riley-strode/ENCE_3231_Riley_Strode_2026/Two_Wheel_Balancing_Robot_v2/Two_Wheel_Balancing_Robot_v2/docs/PCB_Layout.png

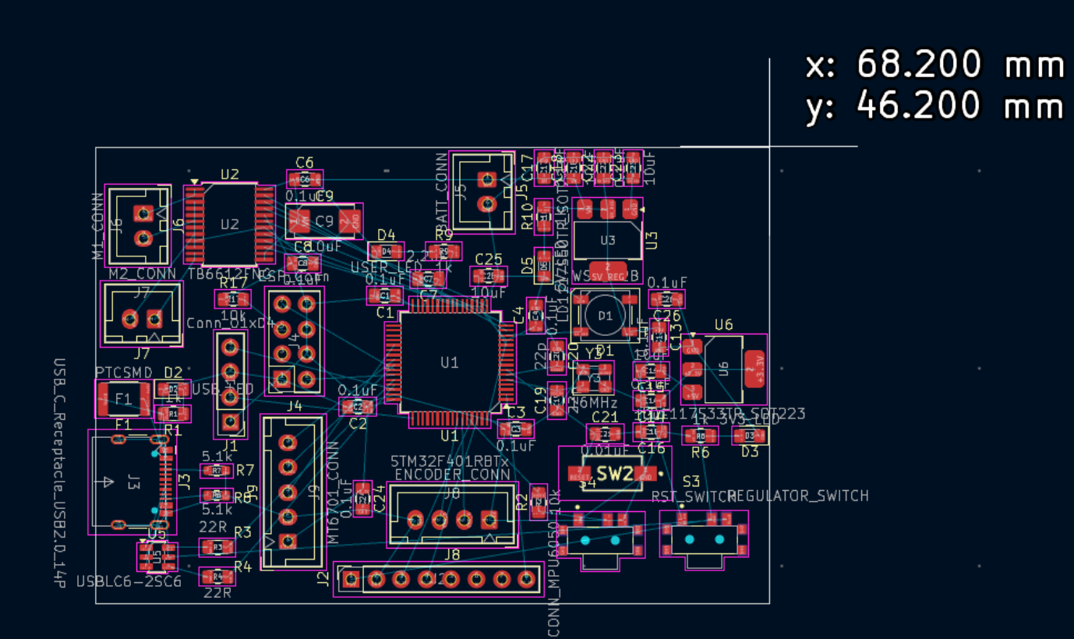
Two_Wheel_Balancing_Robot_v2/Two_Wheel_Balancing_Robot_v2/docs/PCB_Layout.png
