riley-strode/ENCE_3231_Riley_Strode_2026/Phase_D/Riley_Chassis_v4.DXF

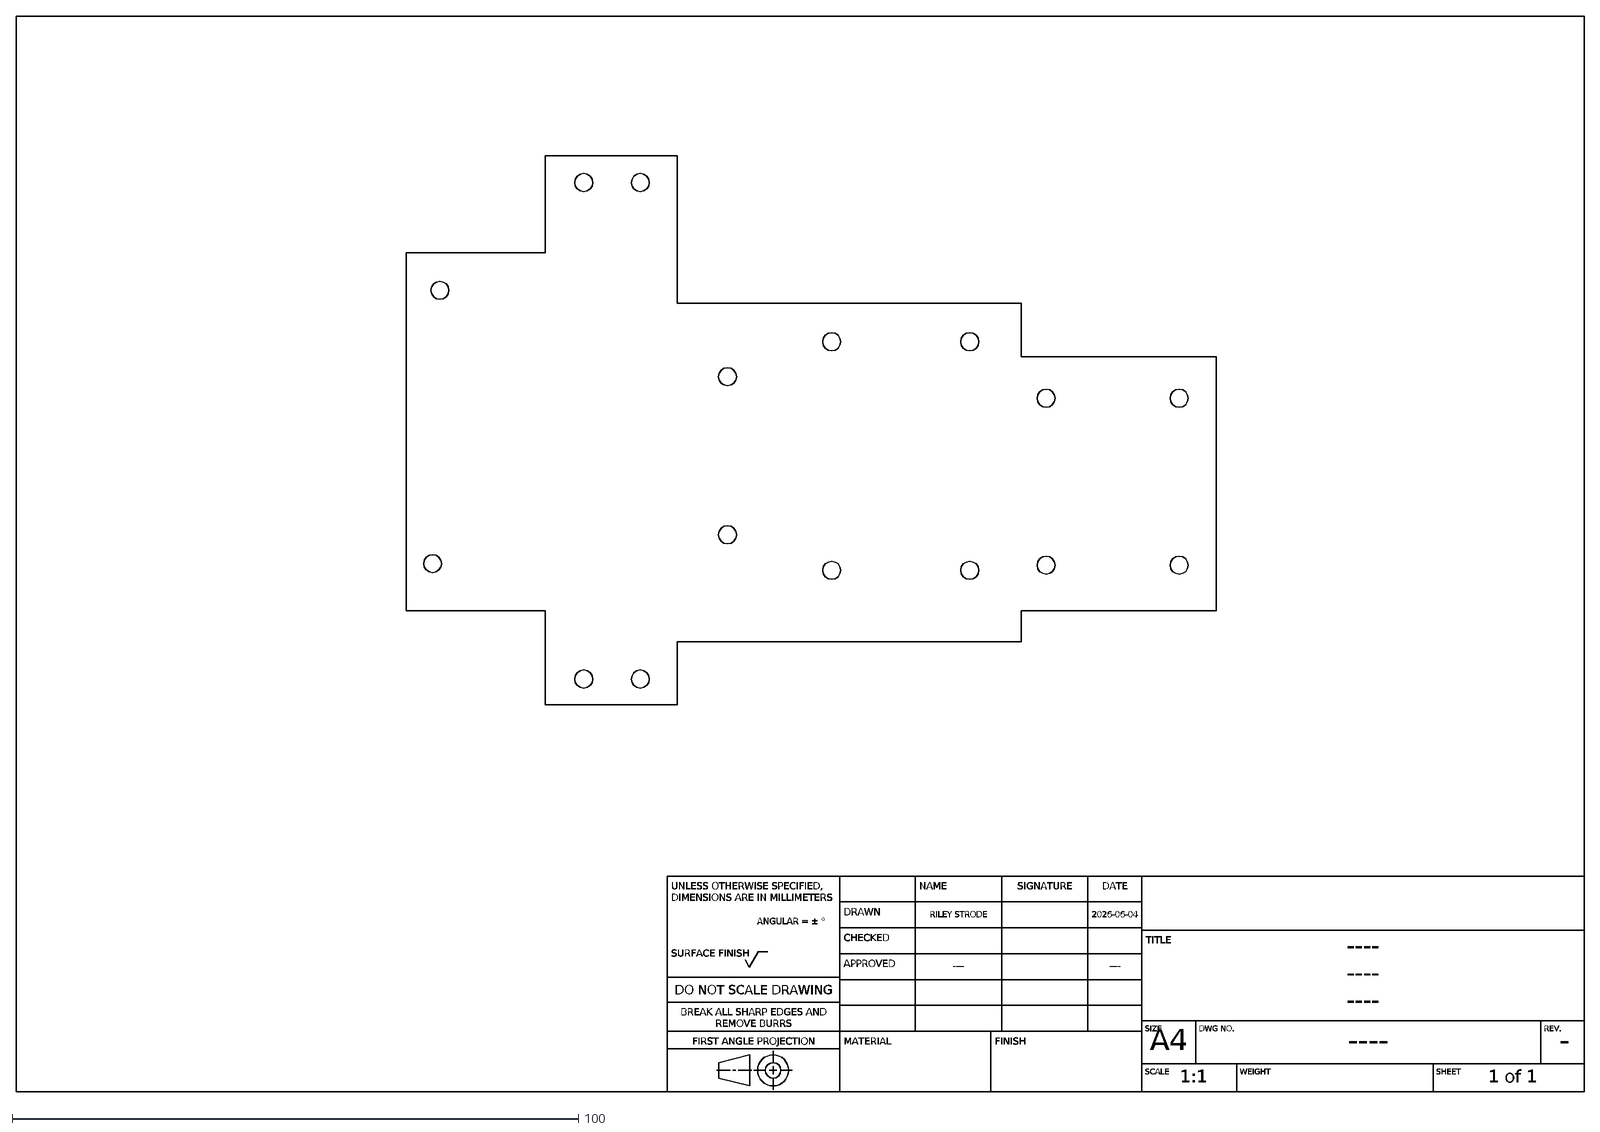
[picture p11: CAD file, 2026-06-09]
Phase_D/Riley_Chassis_v4.DXF
UNLESS OTHERWISE SPECIFIED, DIMENSIONS ARE IN MILLIMETERS
ANGULAR = ± °
SURFACE FINISH
DO NOT SCALE DRAWING
BREAK ALL SHARP EDGES AND REMOVE BURRS
FIRST ANGLE PROJECTION
SIGNATURE
NAME
DATE
DRAWN
RILEY STRODE
2026-06-04
CHECKED
APPROVED
----
MATERIAL
FINISH
TITLE
SIZE
A4
DWG NO.
REV.
-
SCALE
1:1
WEIGHT
SHEET
1 of 1
