riley-strode/ENCE_3231_Riley_Strode_2026/Phase_D/Two_Wheel_Balancing_Robot_v3_KiCad/components/ESP8266-01_ESP-01/step/ESP8266-01_ESP-01.step

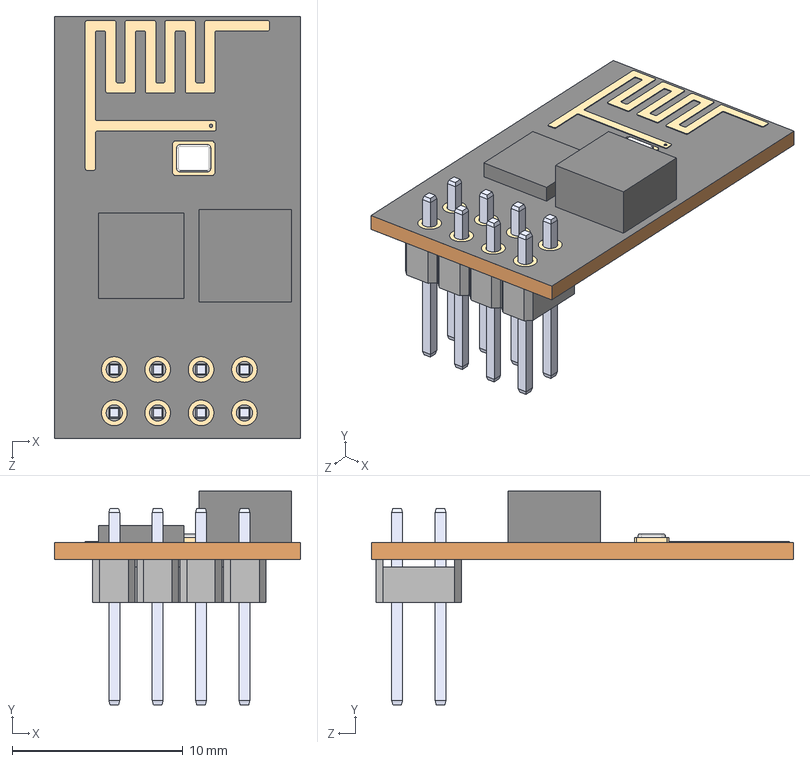
[picture p13: CAD file, 2026-04-23]
Phase_D/Two_Wheel_Balancing_Robot_v3_KiCad/components/ESP8266-01_ESP-01/step/ESP8266-01_ESP-01.step
14.4 x 12.5 x 24.7 mm
