riley-strode/ENCE_3231_Riley_Strode_2026/Phase_D/Two_Wheel_Balancing_Robot_v3_KiCad/components/Fuse_3DModel/MF-MSMF050-2--3DModel-STEP-56544.STEP

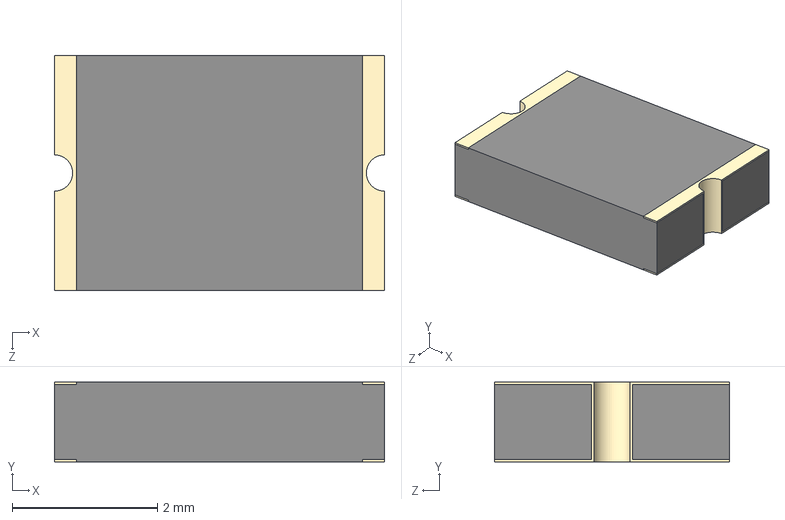
[picture p14: CAD file, 2026-04-23]
Phase_D/Two_Wheel_Balancing_Robot_v3_KiCad/components/Fuse_3DModel/MF-MSMF050-2--3DModel-STEP-56544.STEP
4.55 x 1.10 x 3.24 mm
