riley-strode/ENCE_3231_Riley_Strode_2026/Phase_D/Two_Wheel_Balancing_Robot_v3_KiCad/components/MPU6050/ITG-MPU.STEP

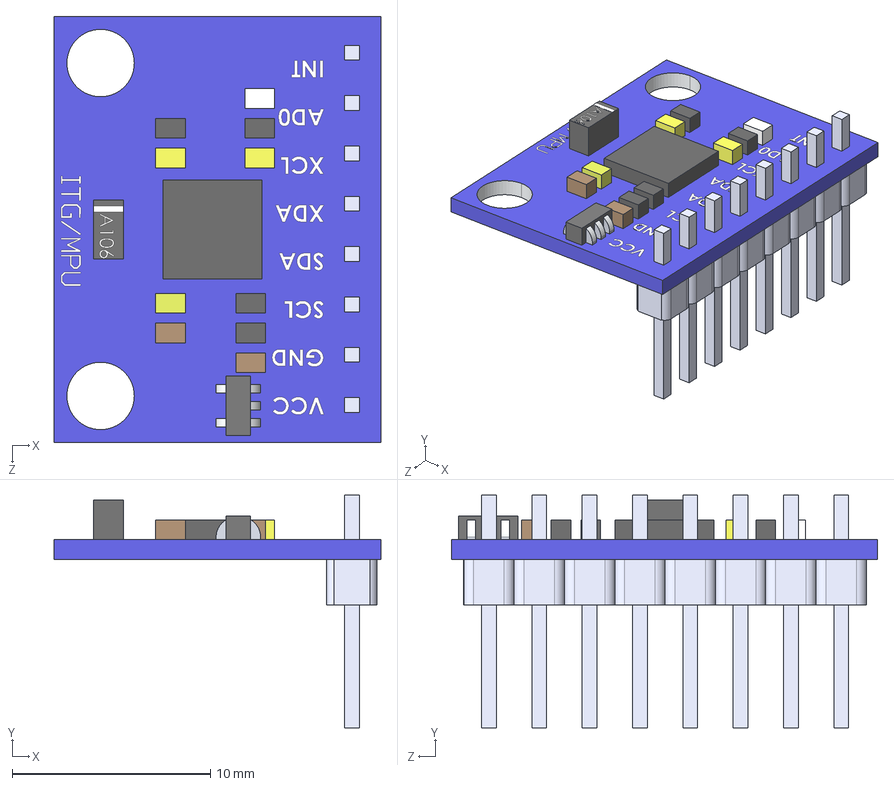
[picture p15: CAD file, 2026-04-23]
Phase_D/Two_Wheel_Balancing_Robot_v3_KiCad/components/MPU6050/ITG-MPU.STEP
16.5 x 11.8 x 21.5 mm
8 Header-Pin
Placa_Base
