riley-strode/ENCE_3231_Riley_Strode_2026/Phase_D/Two_Wheel_Balancing_Robot_v3_KiCad/components/SPDT_Slide_Switch/step/SLW-66527511-SMT-TR.step

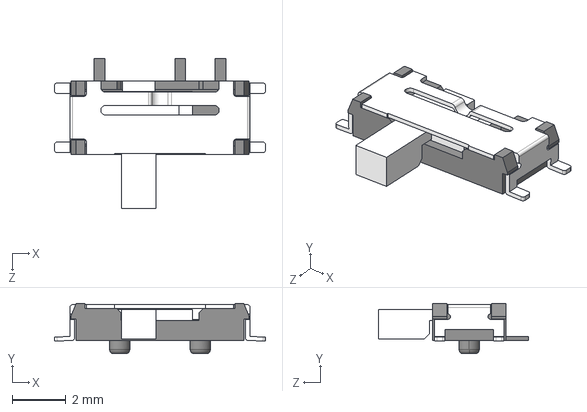
[picture p16: CAD file, 2026-04-23]
Phase_D/Two_Wheel_Balancing_Robot_v3_KiCad/components/SPDT_Slide_Switch/step/SLW-66527511-SMT-TR.step
7.86 x 1.88 x 5.58 mm
