riley-strode/ENCE_3231_Riley_Strode_2026/Phase_D/Two_Wheel_Balancing_Robot_v3_KiCad/components/SW_uP_Reset/step/SW_uP_Reset.stp

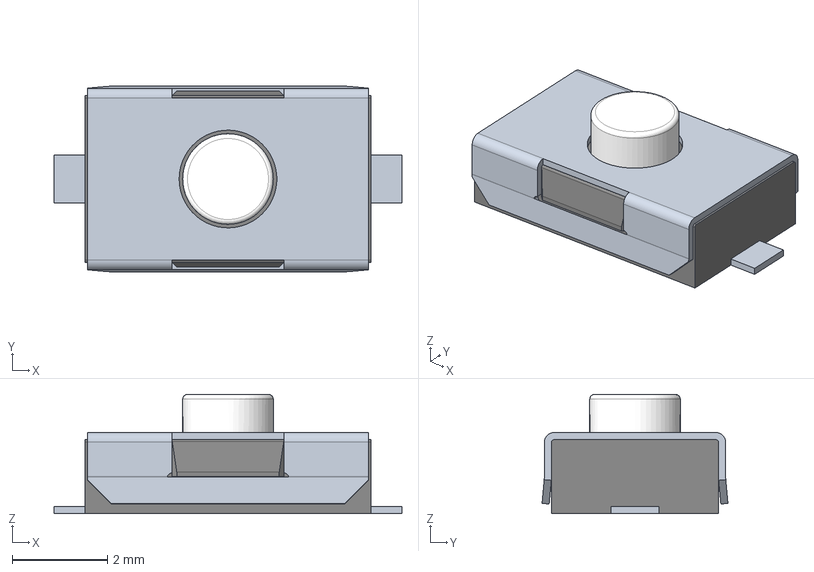
[picture p17: CAD file, 2026-04-23]
Phase_D/Two_Wheel_Balancing_Robot_v3_KiCad/components/SW_uP_Reset/step/SW_uP_Reset.stp
7.30 x 3.90 x 2.50 mm

Phil's_Lab_Tutorial_Folder/Phil's_Lab_Tutorial/Components/629105150521 (rev1).stp
8.00 x 6.60 x 4.52 mm
629105150521_Housing
629105150521_Pin1 x 4
629105150521_Pin2
629105150521_Shielding2
629105150521_Shielding
