riley-strode/ENCE_3231_Riley_Strode_2026/(list of files, cad)

Other CAD files:
Phase_D/Two_Wheel_Balancing_Robot_v3_KiCad/docs/CAD_BASE_WHEEL_BALANCE.step
