riley-strode/ENCE_3231_Riley_Strode_2026/Lab_1_Ultrasonic_Sensor/Embedded Systems Lab 1 Block Diagram 1.pdf

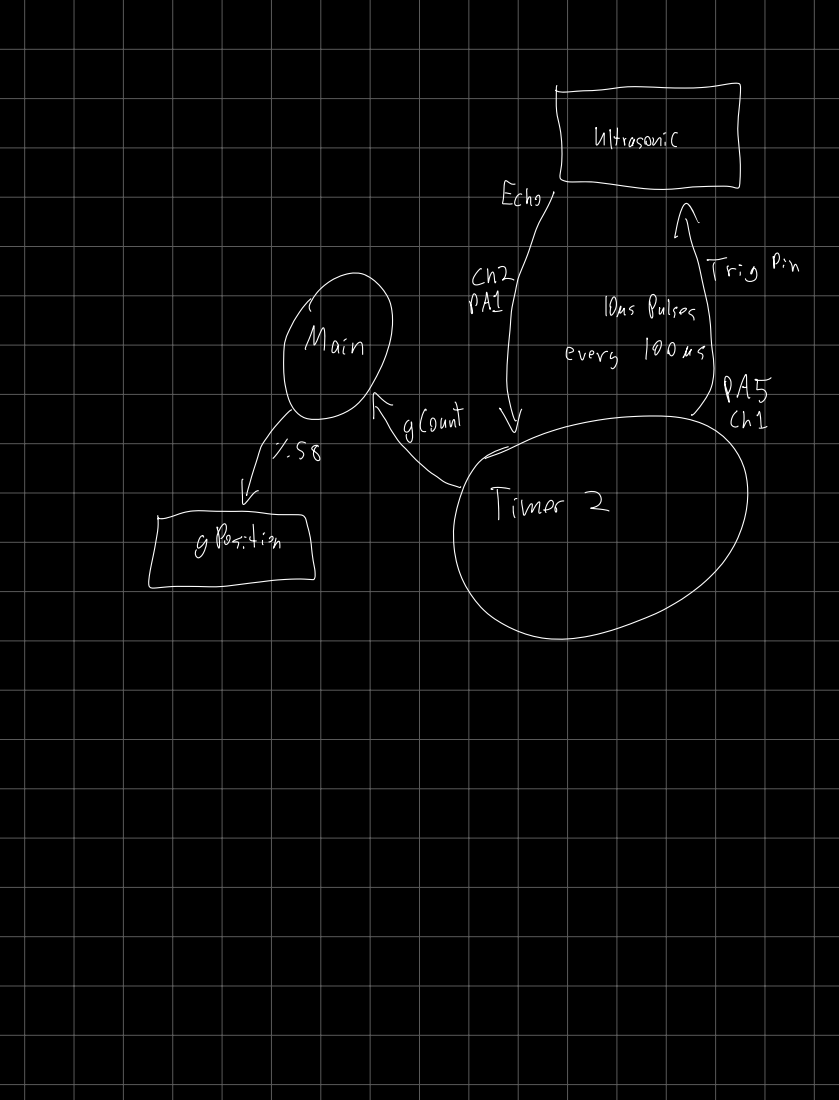
[picture p19: page 1]
UltrasonicEchoTrig; PinCh2; PAI10ms; Pulses; every 100msMainPAS Ch1glount1 58Timer; Position
