riley-strode/ENCE_3231_Riley_Strode_2026/Phase_D/Riley_Chassis_v4.pdf

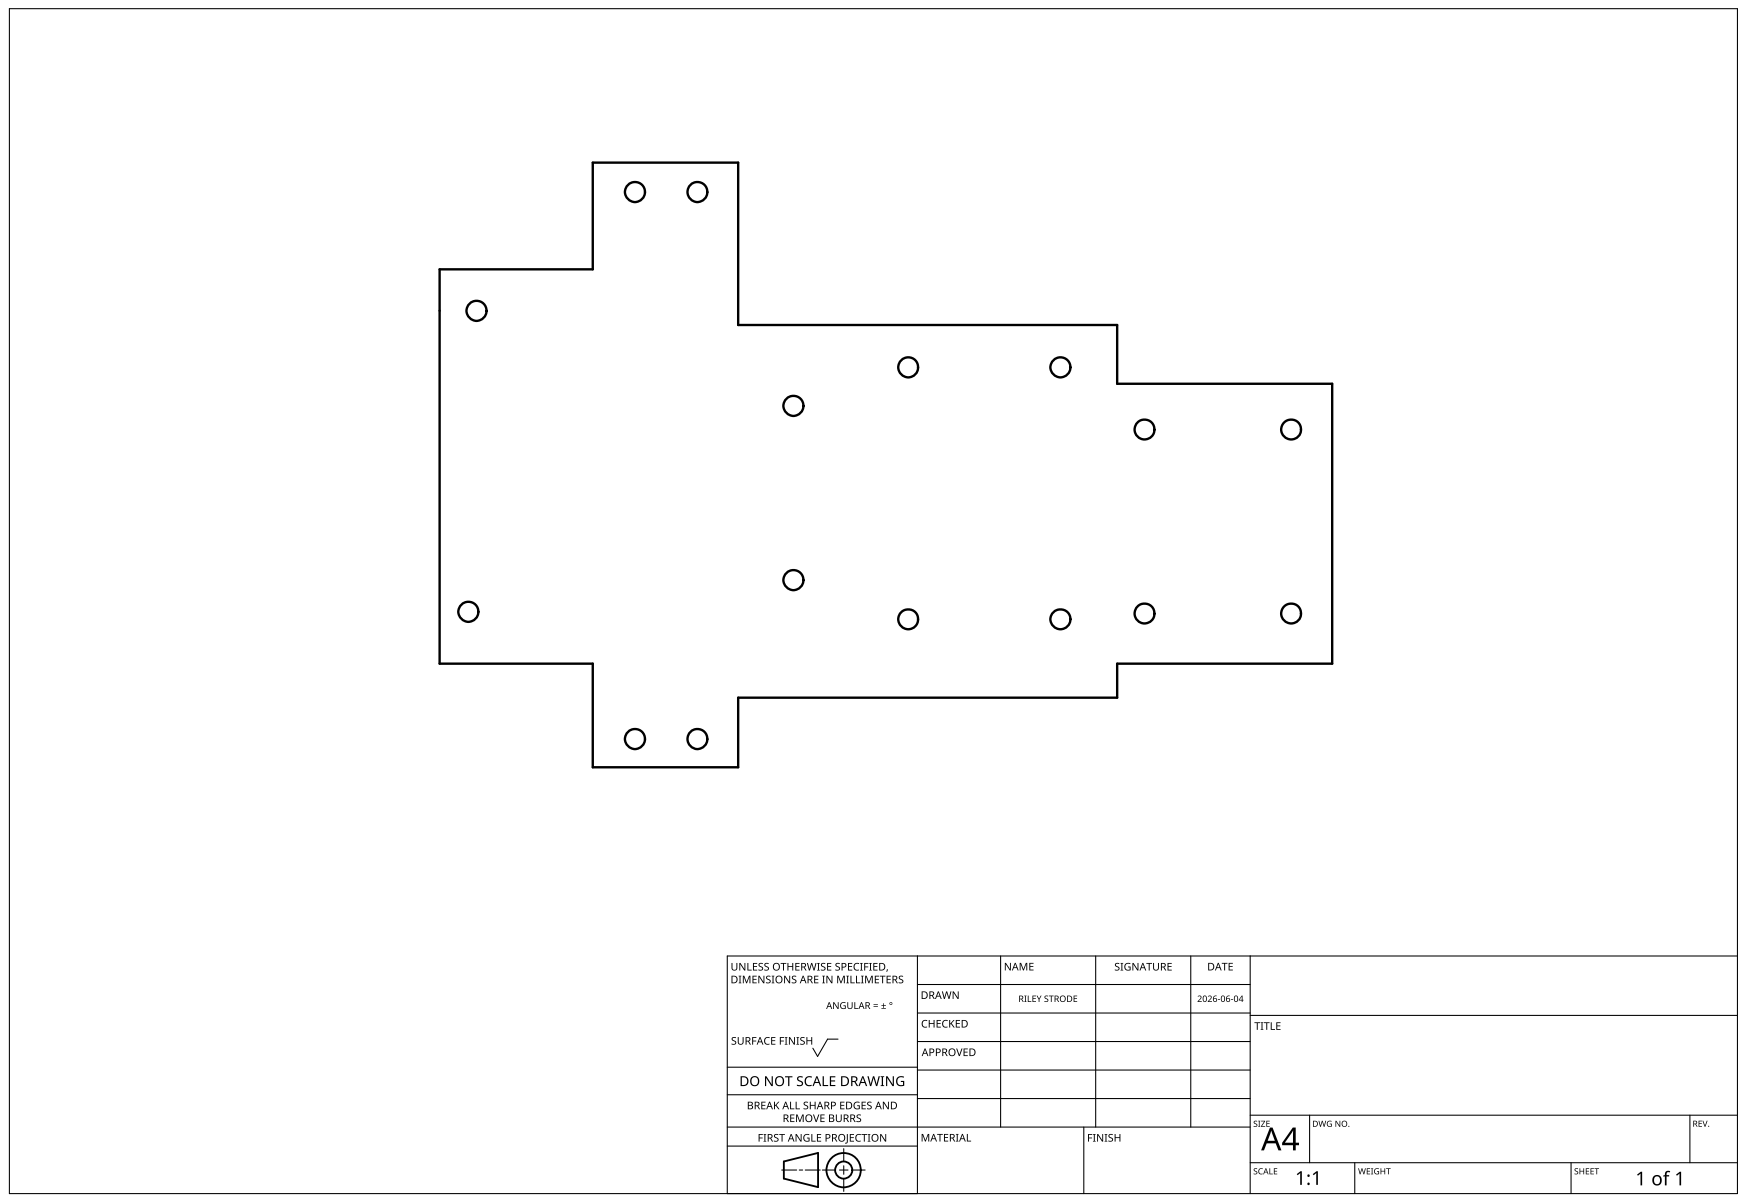
[picture p20: page 1]
