riley-strode/ENCE_3231_Riley_Strode_2026/Phase_D/Two_Wheel_Balancing_Robot_v3_KiCad/docs/Riley_Strode_Chassis.pdf

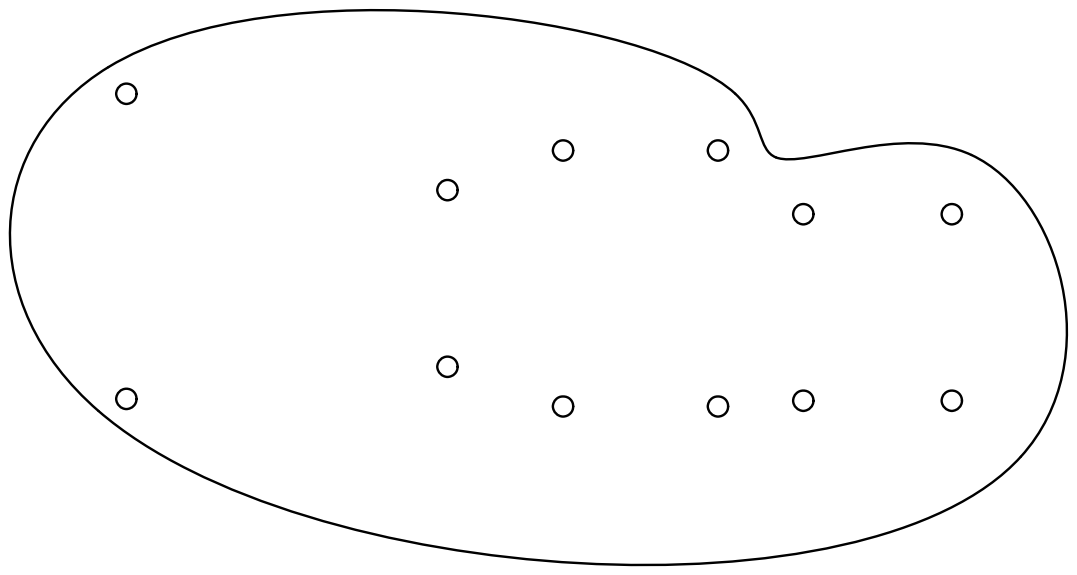
[picture p21: page 1]
