riley-strode/ENCE_3231_Riley_Strode_2026/Phase_D/Two_Wheel_Balancing_Robot_v3_KiCad/docs/Riley_Strode_Chassis_v2.pdf

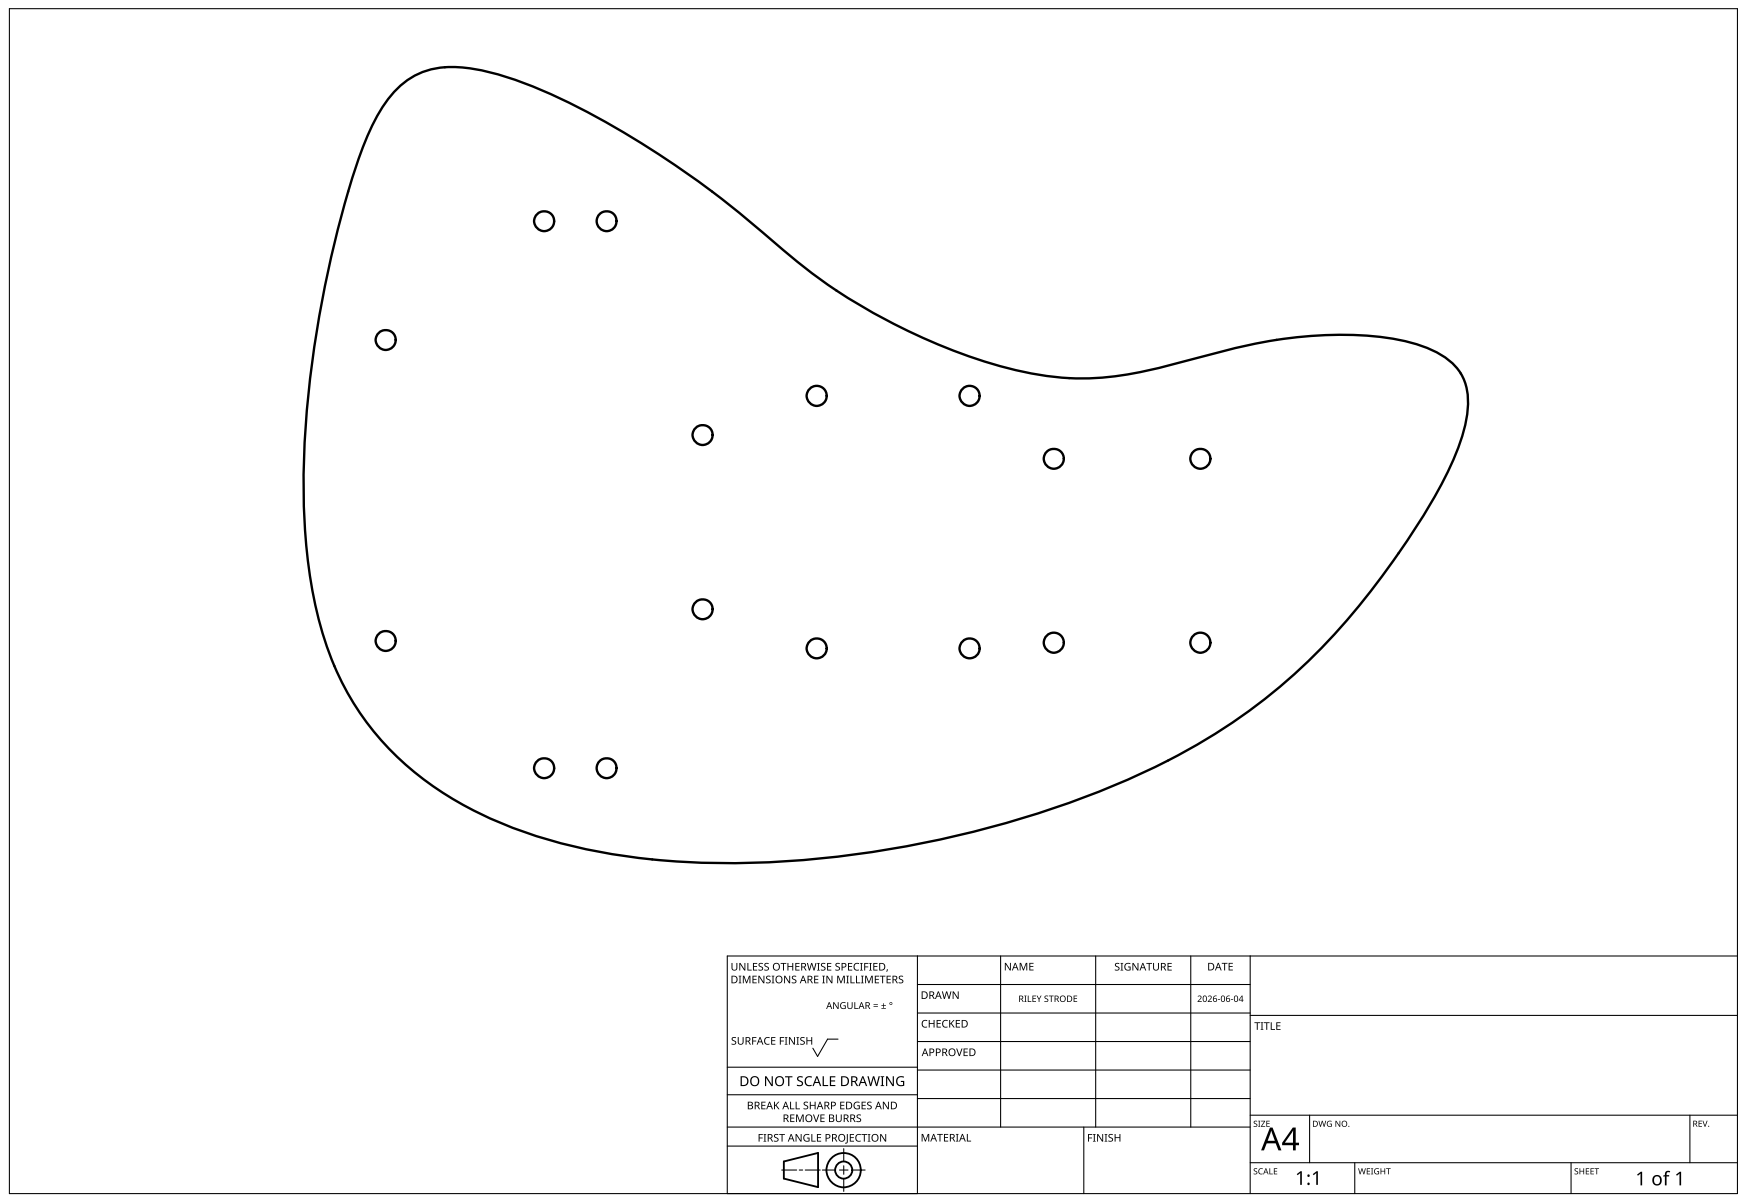
[picture p22: page 1]
