riley-strode/ENCE_3231_Riley_Strode_2026/Phil's_Lab_Tutorial_Folder/Phil's_Lab_Tutorial/Phil's_Lab_Tutorial.kicad_pcb

## KiCad design Phil's_Lab_Tutorial_Folder/Phil's_Lab_Tutorial/Phil's_Lab_Tutorial.kicad_pcb (2026-04-28)

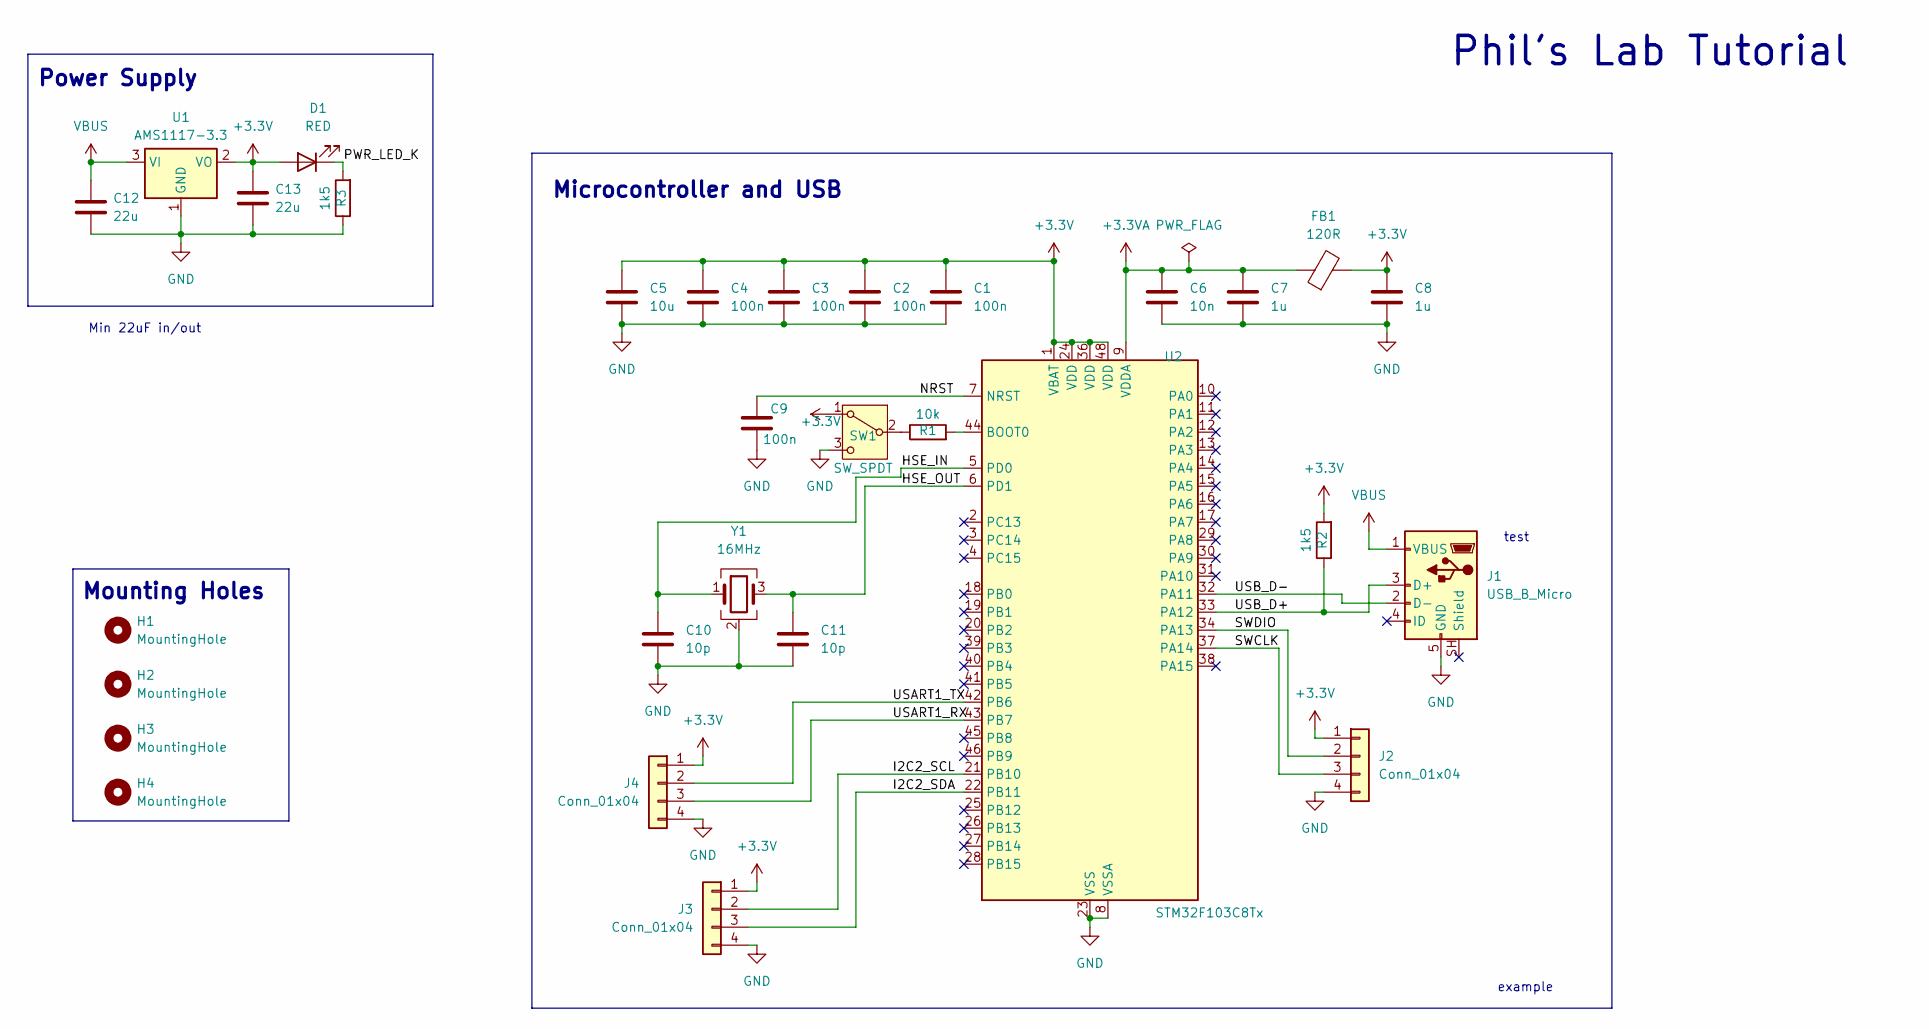
[picture p25: schematic Phil's_Lab_Tutorial.kicad_sch, Phil's Lab Tutorial]

Parts:
C1, C2, C3, C4, C9: 100n; C_0402_1005Metric
C5: 10u; C_0603_1608Metric
C6: 10n; C_0603_1608Metric
C7, C8: 1u; C_0402_1005Metric
C10, C11: 10p; C_0402_1005Metric
C12, C13: 22u; C_0805_2012Metric
D1: RED; LED_0603_1608Metric
FB1: 120R; L_0603_1608Metric
H1, H2, H3, H4: MountingHole; MountingHole_2.2mm_M2
J1: USB_B_Micro; USB_Micro-B_Technik_TWP-4002D-H3
J2, J3, J4: Conn_01x04; PinHeader_1x04_P2.54mm_Vertical
R1: 10k; R_0402_1005Metric
R2, R3: 1k5; R_0402_1005Metric
SW1: SW_SPDT; SuperSOT-3
U1: AMS1117-3.3; SOT-223-3_TabPin2
U2: STM32F103C8Tx; LQFP-48_7x7mm_P0.5mm
Y1: 16MHz; Crystal_SMD_3225-4Pin_3.2x2.5mm

Connections:
+3.3V: C1.1, C2.1, C3.1, C4.1, C5.1, C8.1, C13.1, D1.2 (A), FB1.2, J2.1, J3.1, J4.1, R2.2, SW1.1 (A), U1.2 (VO), U2.1 (VBAT), U2.24 (VDD), U2.36 (VDD), U2.48 (VDD)
+3.3VA: C6.1, C7.1, FB1.1, U2.9 (VDDA)
/HSE_IN: C10.1, U2.5 (PD0), Y1.1
/HSE_OUT: C11.1, U2.6 (PD1), Y1.3
/I2C2_SCL: J3.2, U2.21 (PB10)
/I2C2_SDA: J3.3, U2.22 (PB11)
/NRST: C9.1, U2.7 (NRST)
/PWR_LED_K: D1.1 (K), R3.2
/SWCLK: J2.3, U2.37 (PA14)
/SWDIO: J2.2, U2.34 (PA13)
/USART1_RX: J4.3, U2.43 (PB7)
/USART1_TX: J4.2, U2.42 (PB6)
/USB_D+: J1.3 (D+), R2.1, U2.33 (PA12)
/USB_D-: J1.2 (D-), U2.32 (PA11)
GND: C1.2, C2.2, C3.2, C4.2, C5.2, C6.2, C7.2, C8.2, C9.2, C10.2, C11.2, C12.2, C13.2, J1.5 (GND), J2.4, J3.4, J4.4, R3.1, SW1.3 (C), U1.1 (GND), U2.8 (VSSA), U2.23 (VSS), U2.35 (VSS), U2.47 (VSS), Y1.2 (G), Y1.4 (G)
unnamed: R1.1, SW1.2 (B)
unnamed: R1.2, U2.44 (BOOT0)
VBUS: C12.1, J1.1 (VBUS), U1.3 (VI)

Notes on the sheet:
Microcontroller and USB
Mounting Holes
example
Phil's Lab Tutorial
Min 22uF in/out
Power Supply
test

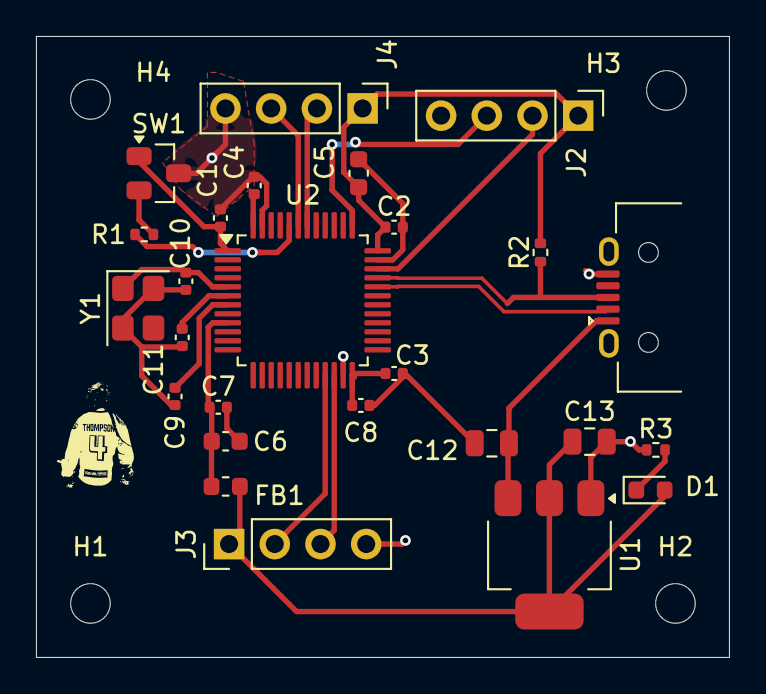
[picture p26: board Phil's_Lab_Tutorial.kicad_pcb from above]

Board: 2 copper layers, 38.5 x 34.5 mm, 30 parts (0 on the bottom side), 18 nets.
