riley-strode/ENCE_3231_Riley_Strode_2026/Two_Wheel_Balancing_Robot_v1/Two_Wheel_Balancing_Robot_v1.kicad_pcb

## KiCad design Two_Wheel_Balancing_Robot_v1/Two_Wheel_Balancing_Robot_v1.kicad_pcb (2026-04-23, an earlier design)

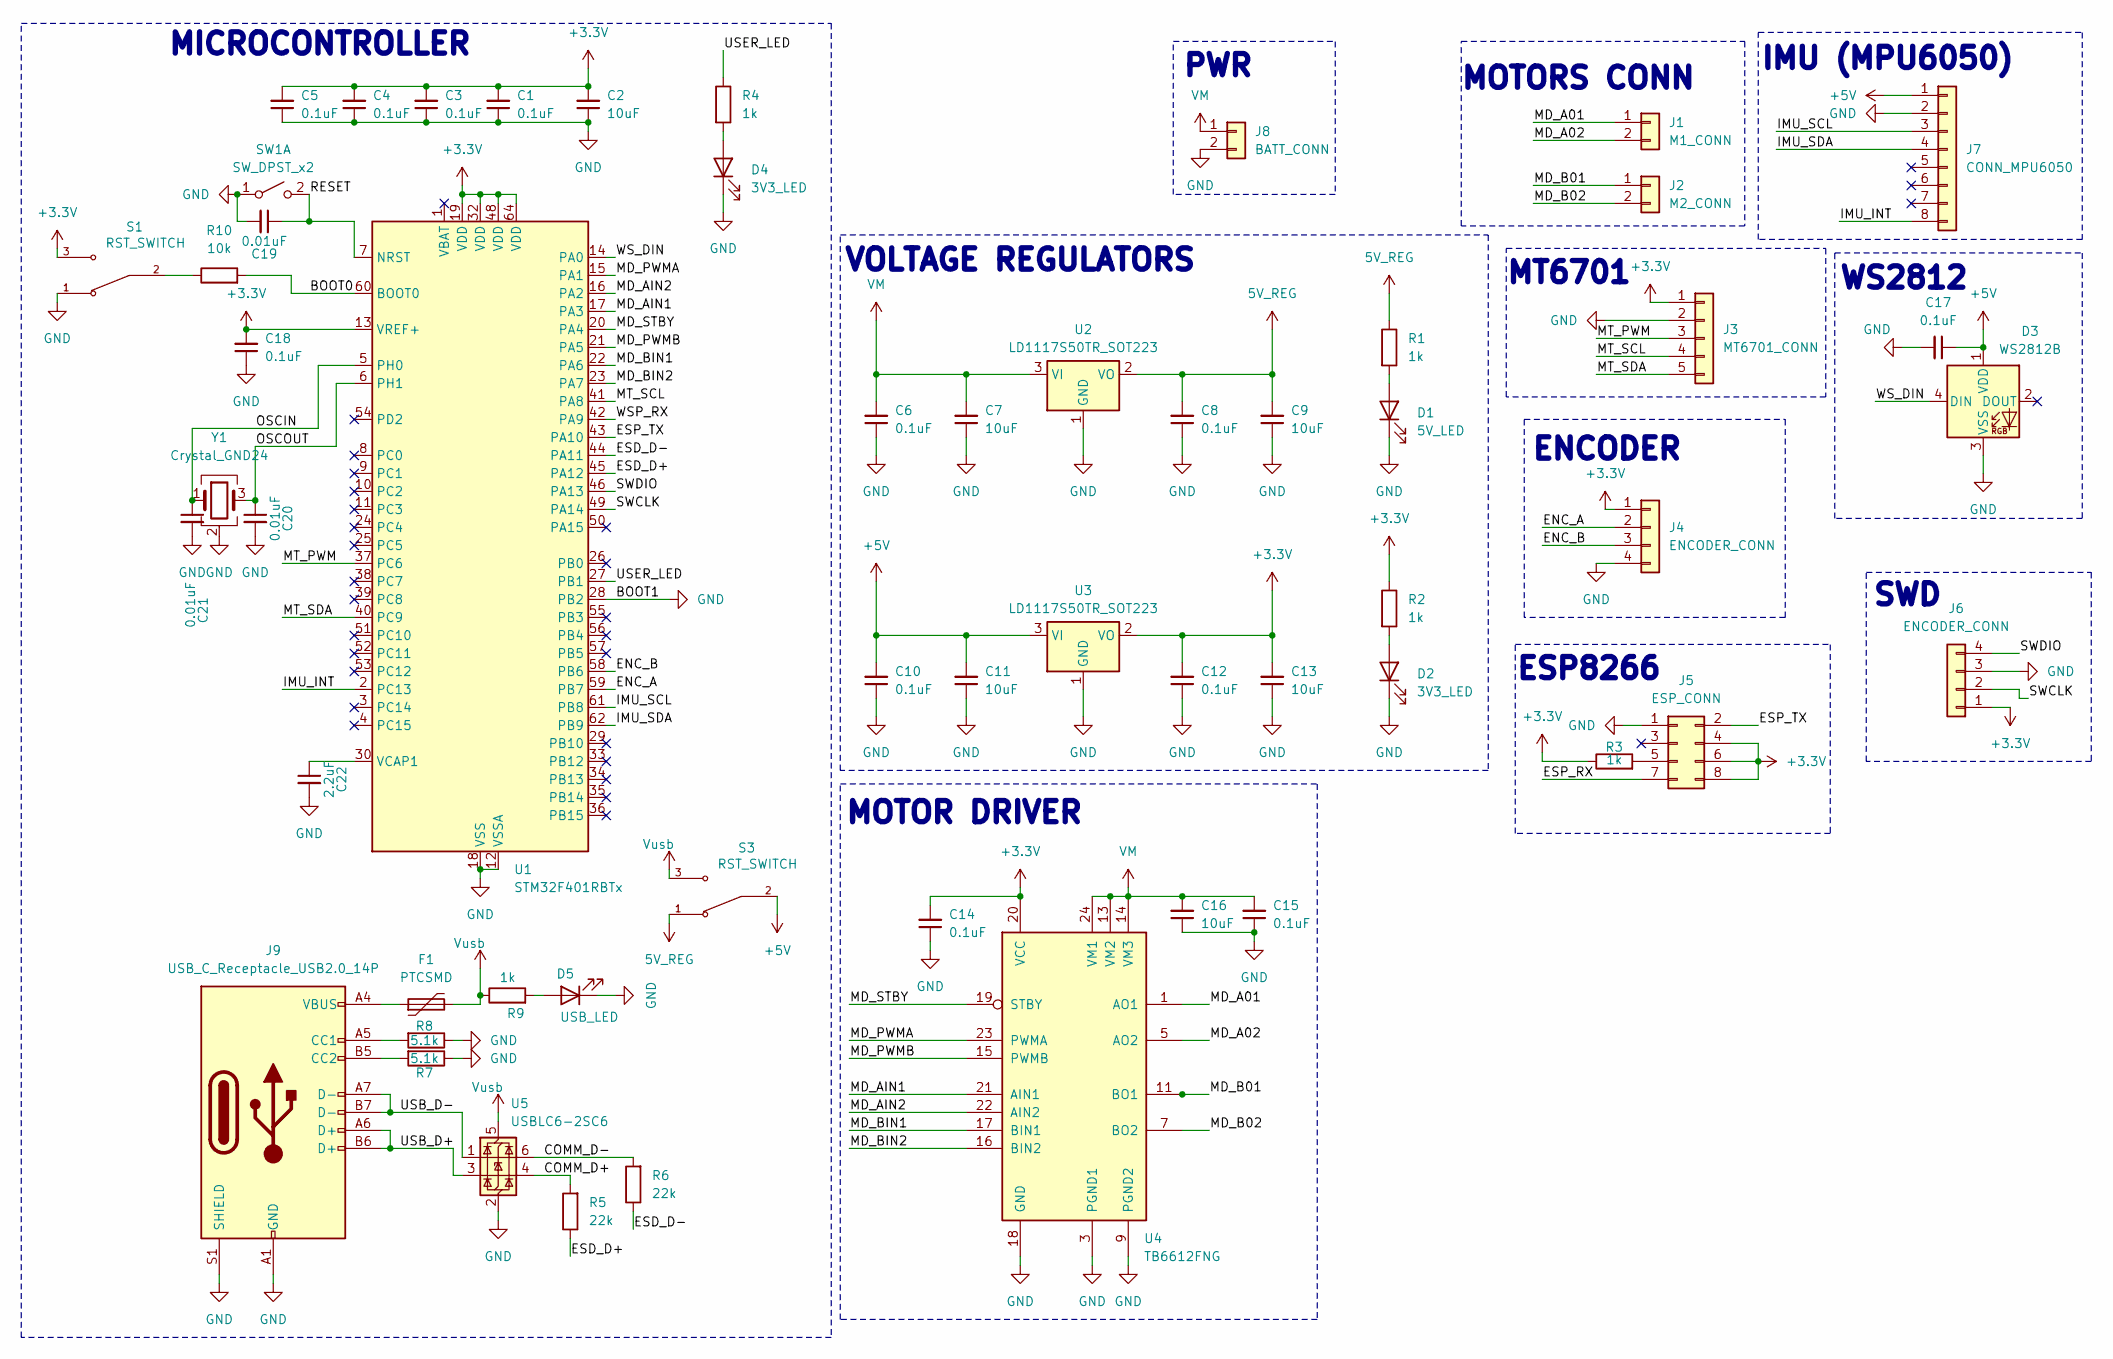
[picture p27: schematic Two_Wheel_Balancing_Robot_v1.kicad_sch]

Parts:
C1, C3, C4, C5, C6, C8, C10, C12, C14, C15, C17, C18: 0.1uF; C_0805_2012Metric_Pad1.18x1.45mm_HandSolder; Mfr. # KAM21BR71H104JM
C2, C7, C9, C11, C13, C16: 10uF; C_0805_2012Metric_Pad1.18x1.45mm_HandSolder; Mfr. # CGA4J1X7R0J106K125AC
C19, C20, C21: 0.01uF; C_0805_2012Metric_Pad1.18x1.45mm_HandSolder; Mfr. # KAM21BR71H104JM
C22: 2.2uF; C_0805_2012Metric_Pad1.18x1.45mm_HandSolder; Mfr. # KAM21BR71H104JM
D1: 5V_LED; LED_0805_2012Metric_Pad1.15x1.40mm_HandSolder; Mfr. # LY M676-R2T1-26-Z
D2, D4: 3V3_LED; LED_0805_2012Metric_Pad1.15x1.40mm_HandSolder; Mfr. # LY M676-R2T1-26-Z
D3: WS2812B; LED_WS2812B_PLCC4_5.0x5.0mm_P3.2mm
D5: USB_LED; LED_0805_2012Metric_Pad1.15x1.40mm_HandSolder; Mfr. # LY M676-R2T1-26-Z
F1: PTCSMD; Fuse_1812_4532Metric
J1: M1_CONN; JST_XH_B2B-XH-A_1x02_P2.50mm_Vertical
J2: M2_CONN; JST_XH_B2B-XH-A_1x02_P2.50mm_Vertical
J3: MT6701_CONN; JST_XH_B5B-XH-A_1x05_P2.50mm_Vertical
J4: ENCODER_CONN; JST_XH_B4B-XH-A_1x04_P2.50mm_Vertical
J5: ESP_CONN; PinSocket_2x04_P2.54mm_Vertical
J6: ENCODER_CONN; PinHeader_1x04_P2.54mm_Vertical
J7: CONN_MPU6050; PinSocket_1x08_P2.54mm_Vertical
J8: BATT_CONN; JST_XH_B2B-XH-A_1x02_P2.50mm_Vertical
J9: USB_C_Receptacle_USB2.0_14P; USB_C_Receptacle_HCTL_HC-TYPE-C-16P-01A
R1, R2, R3, R4, R9: 1k; R_0805_2012Metric_Pad1.20x1.40mm_HandSolder; Mfr. # WCR0805LF1001FPLT
R5, R6: 22k; R_0805_2012Metric_Pad1.20x1.40mm_HandSolder; Mfr. # WCR0805LF1001FPLT
R7, R8: 5.1k; R_0805_2012Metric_Pad1.20x1.40mm_HandSolder; Mfr. # WCR0805LF1001FPLT
R10: 10k; R_0805_2012Metric_Pad1.20x1.40mm_HandSolder; Mfr. # WCR0805LF1001FPLT
S1, S3: RST_SWITCH; SW_SLW-66527511-SMT-TR; PARTREV 1.01
SW1: SW_DPST_x2; SW_uP_Reset
U1: STM32F401RBTx; LQFP-64_10x10mm_P0.5mm; Mfr. # STM32F401RET6
U2, U3: LD1117S50TR_SOT223; SOT-223-3_TabPin2
U4: TB6612FNG; SSOP-24_5.3x8.2mm_P0.65mm
U5: USBLC6-2SC6; SOT-23-6
Y1: Crystal_GND24; Crystal_SMD_Abracon_ABM8G-4Pin_3.2x2.5mm

Connections:
5V_REG: C8.2, C9.2, R1.1, S3.1, U2.2 (VO)
+3.3V: C1.2, C2.2, C3.2, C4.2, C5.2, C12.2, C13.2, C14.2, C18.2, J3.1, J4.1, J5.4, J5.6, J5.8, J6.1, R2.1, R3.1, S1.3, U1.13 (VREF+), U1.19 (VDD), U1.32 (VDD), U1.48 (VDD), U1.64 (VDD), U3.2 (VO), U4.20 (VCC)
+5V: C10.2, C11.2, C17.1, D3.1 (VDD), J7.1, S3.2, U3.3 (VI)
/BOOT0: R10.2, U1.60 (BOOT0)
/COMM_D+: R5.2, U5.4 (I/O2)
/COMM_D-: R6.2, U5.6 (I/O1)
/ENC_A: J4.2, U1.59 (PB7)
/ENC_B: J4.3, U1.58 (PB6)
/ESD_D+: R5.1, U1.45 (PA12)
/ESD_D-: R6.1, U1.44 (PA11)
/ESP_RX: J5.7
/ESP_TX: J5.2, U1.43 (PA10)
/IMU_INT: J7.8, U1.2 (PC13)
/IMU_SCL: J7.3, U1.61 (PB8)
/IMU_SDA: J7.4, U1.62 (PB9)
/MD_A01: J1.1, U4.1 (AO1), U4.2 (AO1)
/MD_A02: J1.2, U4.5 (AO2), U4.6 (AO2)
/MD_AIN1: U1.17 (PA3), U4.21 (AIN1)
/MD_AIN2: U1.16 (PA2), U4.22 (AIN2)
/MD_B01: J2.1, U4.11 (BO1), U4.12 (BO1)
/MD_B02: J2.2, U4.7 (BO2), U4.8 (BO2)
/MD_BIN1: U1.22 (PA6), U4.17 (BIN1)
/MD_BIN2: U1.23 (PA7), U4.16 (BIN2)
/MD_PWMA: U1.15 (PA1), U4.23 (PWMA)
/MD_PWMB: U1.21 (PA5), U4.15 (PWMB)
/MD_STBY: U1.20 (PA4), U4.19 (STBY)
/MT_PWM: J3.3, U1.37 (PC6)
/MT_SCL: J3.4, U1.41 (PA8)
/MT_SDA: J3.5, U1.40 (PC9)
/OSCIN: C21.1, U1.5 (PH0), Y1.1
/OSCOUT: C20.1, U1.6 (PH1), Y1.3
/RESET: C19.1, SW1.2 (B), U1.7 (NRST)
/SWCLK: J6.2, U1.49 (PA14)
/SWDIO: J6.4, U1.46 (PA13)
/USB_D+: J9.A6 (D+), J9.B6 (D+), U5.3 (I/O2)
/USB_D-: J9.A7 (D-), J9.B7 (D-), U5.1 (I/O1)
/USER_LED: R4.1, U1.27 (PB1)
/WSP_RX: U1.42 (PA9)
/WS_DIN: D3.4 (DIN), U1.14 (PA0)
GND: C1.1, C2.1, C3.1, C4.1, C5.1, C6.1, C7.1, C8.1, C9.1, C10.1, C11.1, C12.1, C13.1, C14.1, C15.1, C16.1, C17.2, C18.1, C19.2, C20.2, C21.2, C22.2, D1.1 (K), D2.1 (K), D3.3 (VSS), D4.1 (K), D5.1 (K), J3.2, J4.4, J5.1, J6.3, J7.2, J8.2, J9.A1 (GND), J9.A12 (GND), J9.B1 (GND), J9.B12 (GND), J9.S1 (SHIELD), R7.1, R8.1, S1.1, SW1.1 (A), U1.12 (VSSA), U1.18 (VSS), U1.28 (PB2), U1.31 (VSS), U1.47 (VSS), U1.63 (VSS), U2.1 (GND), U3.1 (GND), U4.3 (PGND1), U4.4 (PGND1), U4.9 (PGND2), U4.10 (PGND2), U4.18 (GND), U5.2 (GND), Y1.2 (G), Y1.4 (G)
unnamed: D1.2 (A), R1.2
unnamed: D2.2 (A), R2.2
unnamed: D4.2 (A), R4.2
unnamed: D5.2 (A), R9.2
unnamed: F1.1, J9.A4 (VBUS), J9.A9 (VBUS), J9.B4 (VBUS), J9.B9 (VBUS)
unnamed: J5.5, R3.2
unnamed: J9.A5 (CC1), R8.2
unnamed: J9.B5 (CC2), R7.2
unnamed: R10.1, S1.2
unnamed: C22.1, U1.30 (VCAP1)
VM: C6.2, C7.2, C15.2, C16.2, J8.1, U2.3 (VI), U4.13 (VM2), U4.14 (VM3), U4.24 (VM1)
Vusb: F1.2, R9.1, S3.3, U5.5 (VBUS)

Notes on the sheet:
MT6701
VOLTAGE REGULATORS
WS2812
MICROCONTROLLER
MOTORS CONN
SWD
IMU (MPU6050)
PWR
MOTOR DRIVER
ENCODER
ESP8266

Board: 2 copper layers, 54 parts (0 on the bottom side), 49 nets, no tracks yet.
